mlx-kva/mlx-i2c-stick/readme.md

# mlx-i2c-stick

The web interface here:  
https://melexis.github.io/mlx-i2c-stick/

The mlx-i2c-stick:  
[web_interface/mlx-i2c-stick.md](web_interface/mlx-i2c-stick.md)
