mlx-kva/mlx-i2c-stick/mlx90614-breakout/readme.md

# MLX90614 Breakout

## The sensor

The PCB was ordered at: https://oshpark.com/shared_projects/wEw4JqmG

Breakout PBC for MLX90614:  
https://melexis.com/mlx90614

Buying options for the sensor:

### Standard accuracy:  

- MLX90614ESF-BAA-000-SP: [Mouser](https://www.mouser.com/ProductDetail/Melexis/MLX90614ESF-BAA-000-SP?qs=KuGPmAKtFKWvOyfE%252Bpry0g%3D%3D)
- MLX90614ESF-BCC-000-SP: [Mouser](https://www.mouser.com/ProductDetail/Melexis/MLX90614ESF-BCC-000-SP?qs=KuGPmAKtFKXYssxLPj6I9Q%3D%3D)
- MLX90614ESF-BCF-000-SP: [Mouser](https://www.mouser.com/ProductDetail/Melexis/MLX90614ESF-BCF-000-SP?qs=KuGPmAKtFKXyNGD%252Bez1Dog%3D%3D)
- MLX90614ESF-BCI-000-SP: [Mouser](https://www.mouser.com/ProductDetail/Melexis/MLX90614ESF-BCI-000-SP?qs=KuGPmAKtFKWdLr71JCUGWw%3D%3D)

### Medical Accuracy:

- MLX90614ESF-DCC-000-SP: [Mouser](https://www.mouser.com/ProductDetail/Melexis/MLX90614ESF-DCC-000-SP?qs=KuGPmAKtFKVd5ey8TnlzAw%3D%3D)
- MLX90614ESF-DCI-000-SP: [Mouser](https://www.mouser.com/ProductDetail/Melexis/MLX90614ESF-DCI-000-SP?qs=KuGPmAKtFKWa9YC%2F7FAqHQ%3D%3D)

Or contact our sales team at: https://www.melexis.com/en/contact/sales-contact

## Get started

This board works together with any 3.3V I2C master.  
Have a look at our `MLX I2C STICK` for evaluation pursposes.  
The board uses the QWIIC connector system for I2C & Supply.

QWIIC: https://www.sparkfun.com/qwiic

## The board

### Optional socket:

Mill-Max Manufacturing Corp. - 917-43-104-41-005000  
  
https://www.digikey.com/en/products/detail/mill-max-manufacturing-corp/917-43-104-41-005000/1212171

### Optional spacer:

PCB to sensor spacer:  
https://www.digikey.com/en/products/detail/bivar-inc/514-070/3096249  
https://www.digikey.com/en/products/detail/assmann-wsw-components/V4555/3511514
