mlx-kva/mlx-i2c-stick/firmware_doc/04_byos_extending.md

# Melexis I2C Stick -- ByoS Extending.

ByoS; Bring your own Sensor.

Prequisite is that the sensor uses the I2C interface.  
There are two ways to support this:
- Use the generic `i2c` command to interface the new sensor.
- Add a driver in firmware of the `mlx-i2c-stick`.

## Adding a (software) driver to the firmware.

to do...
