mlx-kva/mlx-i2c-stick/web_interface/products.md

---
title: 'Melexis I2C Stick'
copyright: 'Melexis'
---

## Products

As stated in the `mlx-i2c-stick` introduction, here we focus on our 3.3V supplied & I2C communication protocol product portfolio.

## Non-contact temperature sensors (FIR)

- MLX90632 -> https://melexis.com/mlx90632
- MLX90614 -> https://melexis.com/mlx90614
- MLX90640 -> https://melexis.com/mlx90640
- MLX90641 -> https://melexis.com/mlx90641

## Magnetic Position Sensors

- MLX90393`!` -> https://melexis.com/mlx90393
- MLX90395`!` -> https://melexis.com/mlx90395
- MLX90397`!` -> https://melexis.com/mlx90397

`!`: not yet supported by mlx-i2c-stick firmware V1.1.0
