mlx-kva/mlx-i2c-stick/mlx90640-breakout/output/mlx90640-breakout-BOM.xlsx

Item | Qty | Reference(s) | Value | LibPart | Footprint | Datasheet
1 | 1 | C1 | 100n | pspice:C | Capacitor_SMD:C_0805_2012Metric | ~
2 | 1 | C2 | 10u | pspice:C | Capacitor_SMD:C_0805_2012Metric | ~
3 | 1 | J1 | Conn_01x04_Male | Connector:Conn_01x04_Male | melexis-temperature:QWIIC_STEMMA_QT | https://www.sparkfun.com/products/14417
5 | 2 | R1, R2 | 4K7 | Device:R | Resistor_SMD:R_0805_2012Metric | ~
7 | 1 | U1 | MLX90640 | melexis-temperature:MLX90640 | melexis-temperature:mlx90640_41 | https://melexis.com/mlx90640
 |  |  | Alt #1 | MLX90640ESF-BAA-000-TU | 32x24 pixel, wide field of view
 |  |  | Alt #2 | MLX90640ESF-BAB-000-TU | 32x24 pixel, small field of view
 |  |  | Alt #3 | MLX90641ESF-BCA-000-TU | 16x12 pixel, wide field of view
 |  |  | Alt #4 | MLX90641ESF-BCB-000-TU | 16x12 pixel, small field of view
