mlx-kva/mlx-i2c-stick/mlx90614-breakout/output/mlx90614-breakout-BOM.xlsx

Item | Qty | Reference(s) | Value | LibPart | Footprint | Datasheet | MANUFACTURER
1 | 1 | C1 | 100n | 90632_speculum_flex-rescue:C-pspice | Capacitor_SMD:C_0805_2012Metric
2 | 1 | J1 | Conn_01x04_Male | Connector:Conn_01x04_Male | melexis-temperature:QWIIC_STEMMA_QT | ~ | https://www.sparkfun.com/products/14417
4 | 2 | R1, R2 | 4K7 | Device:R | Resistor_SMD:R_0805_2012Metric | ~
6 | 1 | U1 | MLX90614 | melexis-temperature:MLX90614 | melexis-temperature:mlx90614 | https://melexis.com/mlx90614 | Melexis
 |  |  | Alt #1 | MLX90614ESF-DAA-000-TU | 3V, Medical accuracy, FoV 90, up to 180DegC
 |  |  | Alt #2 | MLX90614ESF-DCC-000-TU | 3V, Medical accuracy, FoV 35, up to 180DegC
 |  |  | Alt #3 | MLX90614ESF-DCI-000-TU | 3V, Medical accuracy, FoV 5, up to 180DegC
 |  |  | Alt #4 | MLX90614ESF-BAA-000-TU | 3V, Standard accuracy, FoV 90, up to 380DegC
 |  |  | Alt #5 | MLX90614ESF-BCC-000-TU | 3V, Standard accuracy, FoV 35, up to 380DegC
 |  |  | Alt #6 | MLX90614ESF-BCI-000-TU | 3V, Standard accuracy, FoV 5, up to 380DegC
 |  | U1-Spacer | optional #1 | white, small spacer |  |  | https://www.digikey.com/en/products/detail/bivar-inc/514-070/3096249
 |  |  | optional #2 | red, larger spacer |  |  | https://www.digikey.com/en/products/detail/assmann-wsw-components/V4555/3511514
