mlx-kva/mlx-i2c-stick/mlx90632-breakout/output/mlx90632-breakout-BOM.xlsx

Item | Qty | Reference(s) | Value | LibPart | Footprint | Datasheet | Field4 | Field5
1 | 1 | C1 | 100n | pspice:CAP | Capacitor_SMD:C_0402_1005Metric | ~
2 | 1 | J1 | Conn_01x04_Male | Connector:Conn_01x04_Male | melexis-temperature:QWIIC_STEMMA_QT | ~ |  | https://www.sparkfun.com/products/14417
3 | 1 | U1 | MLX90632 | melexis-temperature:MLX90632 | melexis-temperature:mlx90632-no-via-large | https://melexis.com/mlx90632 | 3 | MELEXIS
 |  |  | ALT #1 | MLX90632SLD-DCB-000-SP | I2C@3.3V, Medical Accuracy, up to 100 DegC
 |  |  | ALT #2 | MLX90632SLD-BCB-000-SP | I2C@3.3V, Standard Accuracy, up to 200 DegC
