mlx-kva/mlx-i2c-stick/mlx90614-breakout/output/mlx90614-breakout.step

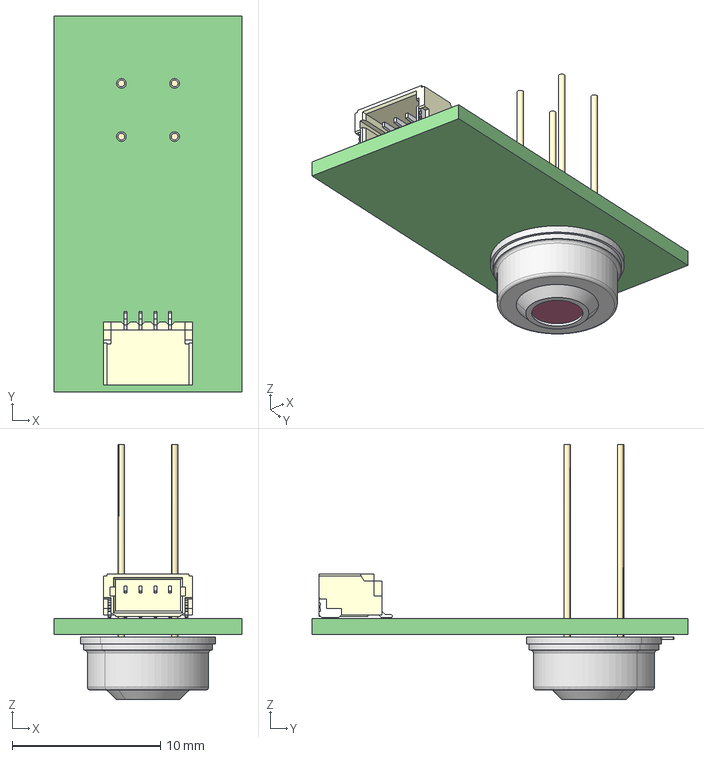
[picture p7: CAD file, 2023-01-17]
mlx90614-breakout/output/mlx90614-breakout.step
12.7 x 25.4 x 17.3 mm
mlx90614-breakout PCB
