mlx-kva/mlx-i2c-stick/mlx90632-breakout/output/mlx90632-breakout.step

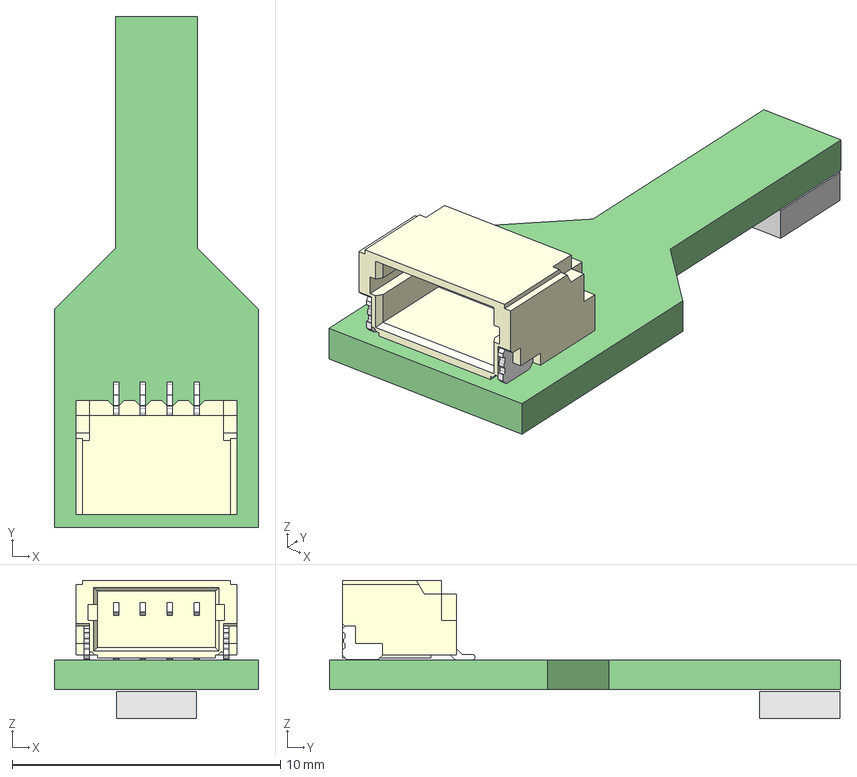
[picture p8: CAD file, 2023-01-17]
mlx90632-breakout/output/mlx90632-breakout.step
7.62 x 19.0 x 5.15 mm
mlx90632-breakout PCB
