mlx-kva/mlx-i2c-stick/mlx90640-breakout/output/mlx90640-breakout.step

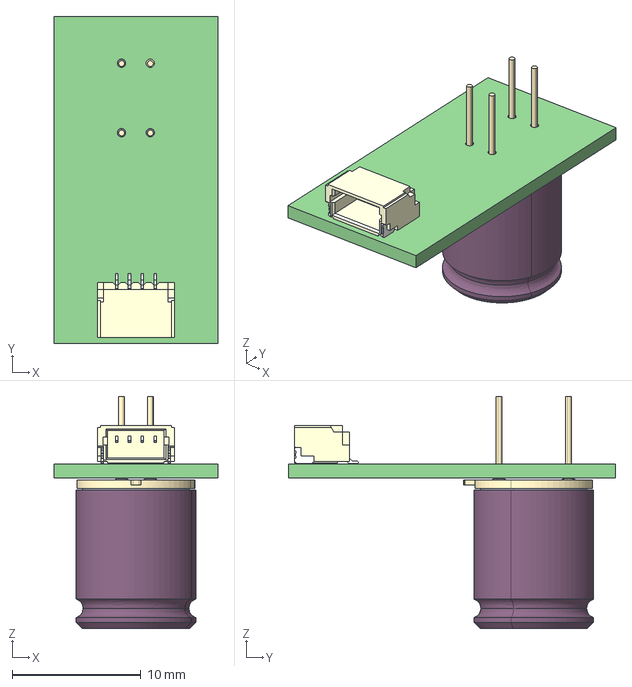
[picture p9: CAD file, 2023-01-17]
mlx90640-breakout/output/mlx90640-breakout.step
12.7 x 25.4 x 18.1 mm
_autosave-mlx90640-breakout PCB
