mlx-kva/mlx-i2c-stick/mlx90614-breakout/output/mlx90614-breakout.pdf

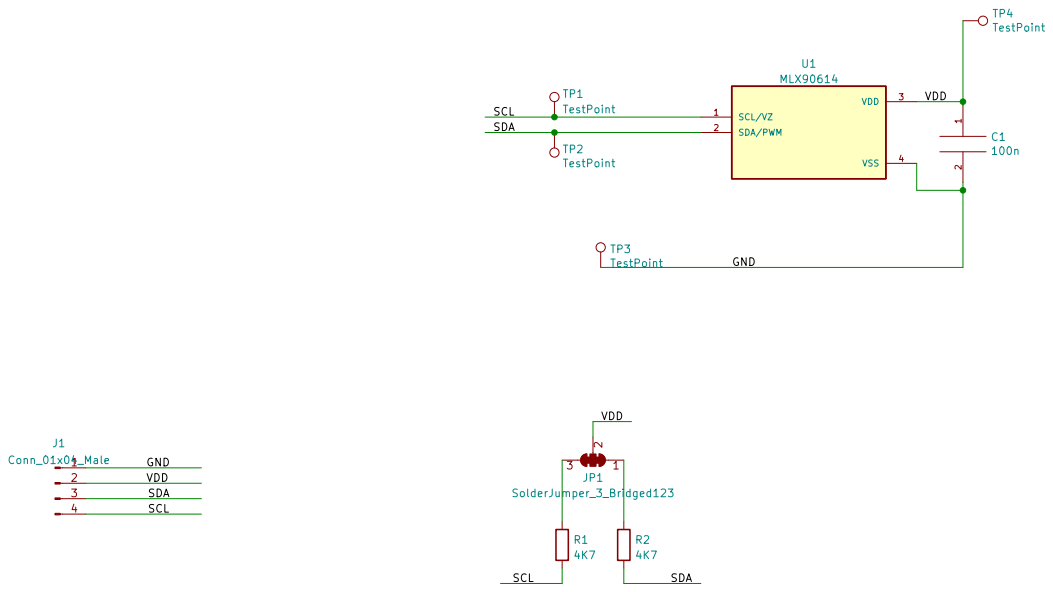
[picture p10: page 1]

File: mlx90614-breakout.kicad_sch Sheet: / Melexis Inc
