mlx-kva/mlx-i2c-stick/mlx90632-breakout/output/mlx90632-breakout.pdf

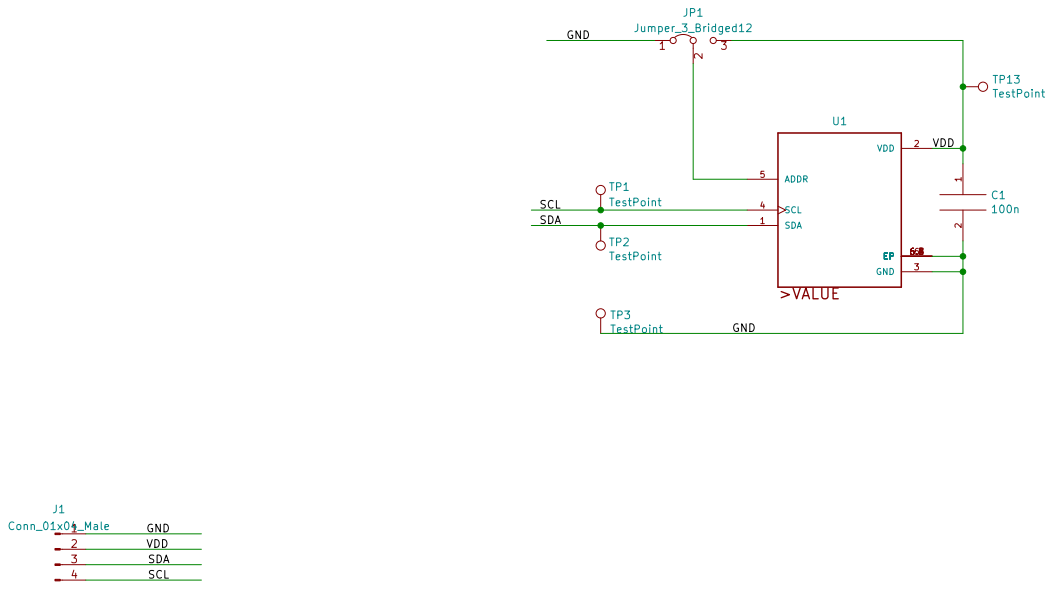
[picture p11: page 1]

File: mlx90632-breakout.kicad_sch Sheet: / Melexis Inc
