mlx-kva/mlx-i2c-stick/mlx90640-breakout/output/mlx90640-breakout.pdf

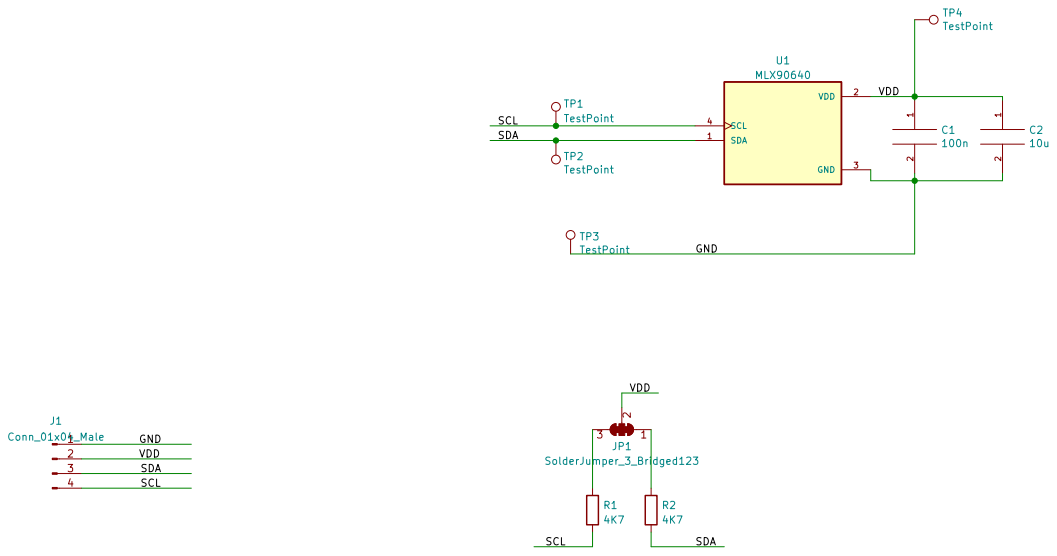
[picture p12: page 1]

File: mlx90640-breakout.kicad_sch Sheet: / Melexis Inc
