mlx-kva/mlx-i2c-stick/(commit log)

2022-11-12 at startup, readback i2c freq from i2c master and update userinterface widgets
2022-11-12 update interface: add boxes around button groups
2022-11-24 moving to bulma css framework
2023-01-17 updated breakout boards
    [mlx90614-breakout-BOM.xlsx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]
